PJ789/Syonara/photos/neo pixel status leds.jpg

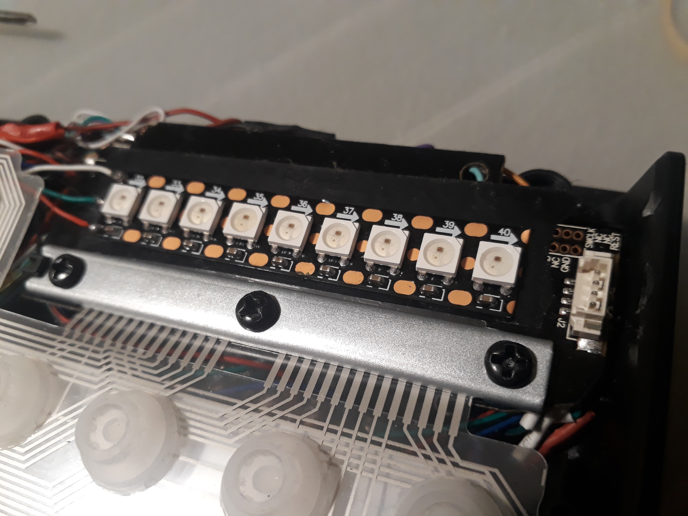
photos/neo pixel status leds.jpg
