PJ789/Syonara/photos/row and column connections.jpg

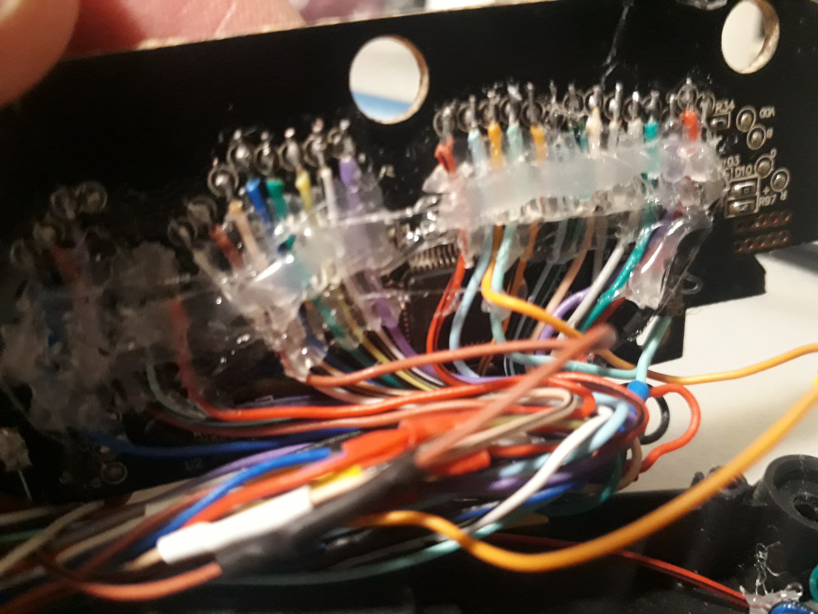
photos/row and column connections.jpg
