PJ789/Syonara/photos/ssmicro and keyboard scanner.jpg

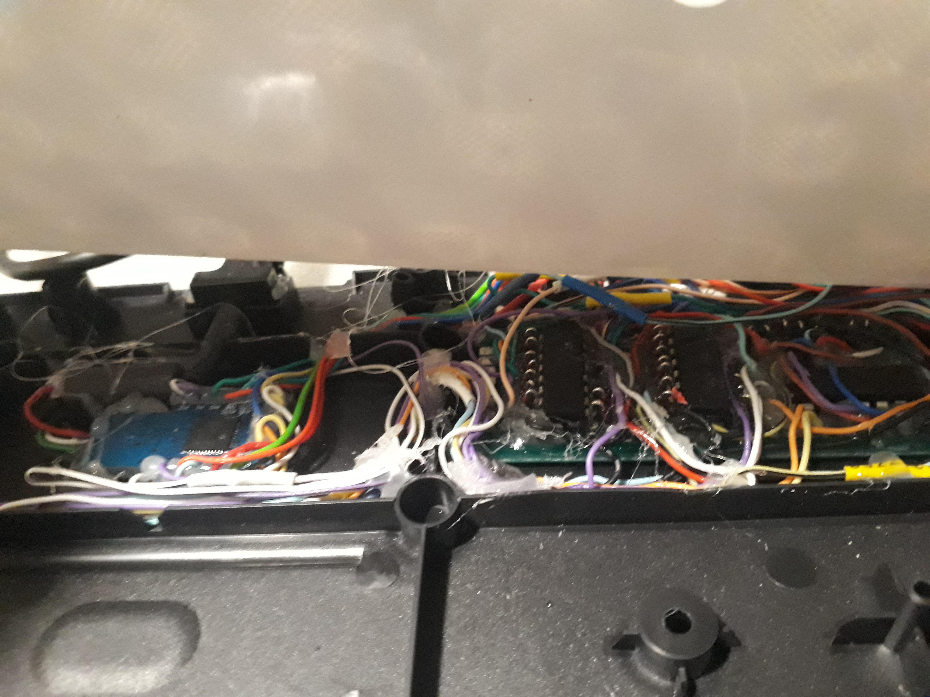
photos/ssmicro and keyboard scanner.jpg
