PJ789/Syonara/photos/ssmicro scanning and pwm amplifier.jpg

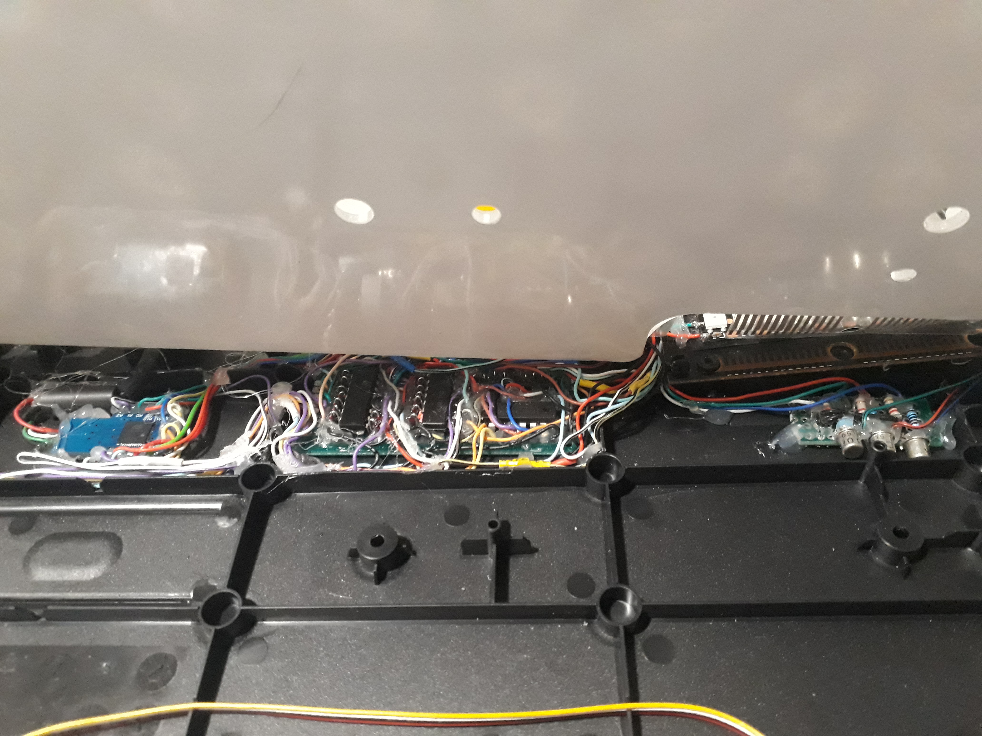
photos/ssmicro scanning and pwm amplifier.jpg
