PJ789/Syonara/photos/syonara!.jpg

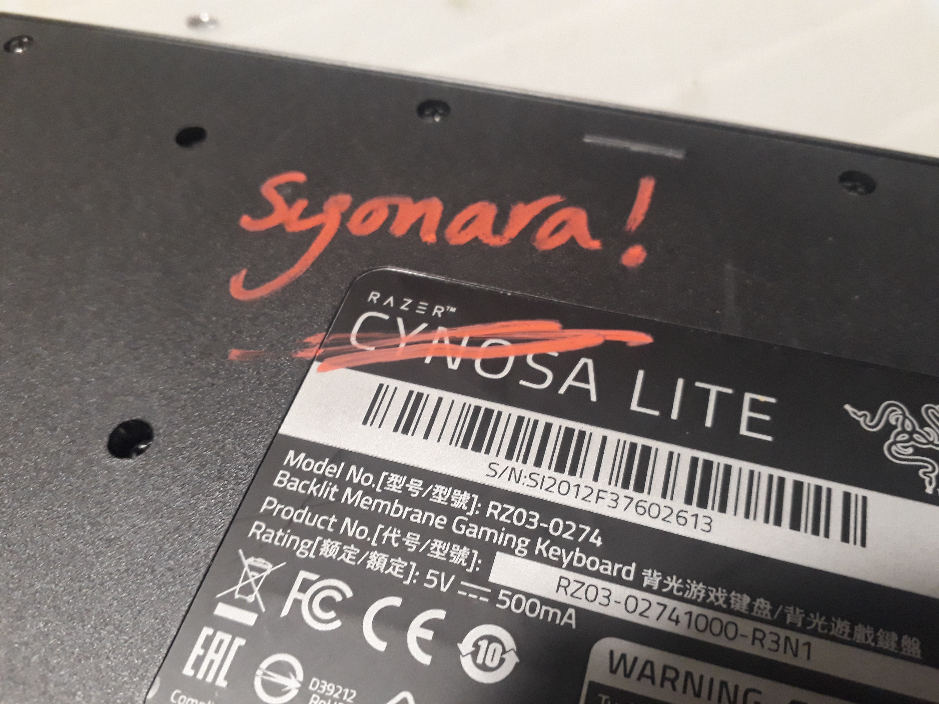
photos/syonara!.jpg
