PJ789/Syonara/(commit log)

2022-01-01 Corrected caps/num lock LED pin assignment
    [Syonara.ino]
2022-01-01 Create BOM
2022-01-01 Update BOM
2022-01-01 Update and rename BOM to BOM.md
2022-01-03 Various fixes & improvements
    Replaces simple status LED handling with more advanced Neopixels.
    Corrects a fault if column n & n+10 are pressed simultaneously (esp. during shift ) , now forcing a reread
    [Syonara.ino]
2022-01-03 Replaced ultrabright LEDs with Neopixels
    Using Neopixels adds more options for effects, and simplifies the wiring.
2022-01-05 Decode optimisation, RGB led setting
    Optimised decoding, applied RGB colour transition effect to status LEDs, replaced NeoPixels Color calls with constants
    [Syonara.ino]
2022-01-05 Performance enhancement
    Switched to static method variables for reduce memory allocation overheads.
2022-01-05 Code quality improvement & bugfix
    [Syonara.ino]
2022-01-05 Fine tune LED power consumption
2022-01-05 Fixed some compiler warnings
    [Syonara.ino]
2022-01-06 Optimised memory use
    Wrapped debug data structures to avoid inclusion in the non-debug build, making more RAM available to the sketch.
    [Syonara.ino]
2022-01-06 Performance tweak: 280->750Hz
2022-01-06 Cut the debounce delay.
2022-01-06 Mapped Fn Button to be Right GUI Key
2022-01-07 Added an alternative circuit design
    An alternative circuit design, that would require a minor modification to the firmware.
    It combines the two reset lines for the decade counters on a single pin, and groups them together on a single AVR port (so they could be reset simultaneously _when needed_).
2022-01-07 Circuit Charge & Performance tweak for lower latency
    Increments both decade counters in one operation, and resets both decade counters using a single pin. Requires a minor change to the pinout of the SSMicro (see wiring diagram).
    [Syonara.ino]
2022-01-07 Moved Counter 1&2 to PortB, Common Reset
    Moves decade counters 1&2 to a common port (port b) allowing them to be incremented in one operation. The decade counter reset lines have been joined to allow them to be reset using a single pin/single operation. See also corresponding code changes to the firmware.
2022-01-09 Added support for changing backlight effect
    Changed code to allow you to switch backlight effects using the right gui button. Choice of effect is persisted in the eeprom.
2022-01-10 Added more LED backlight colour options
2022-01-11 Small performance tweak +2Hz
    Used equality test (not >) in loops
2022-01-12 Performance tweak +1Hz
2022-01-12 Performance & timing enh. +10Hz
2022-01-13 Perf tweak +1Hz
    Broke up the main scan loop into 10 individual steps, so to avoid testing the loop condition on every iteration, and add a little to the speed.
    [Syonara.ino]
